Starlight1856/Seismic-Sensor-From-Hard-Drive-/misc/IMG_20210722_235536.jpg

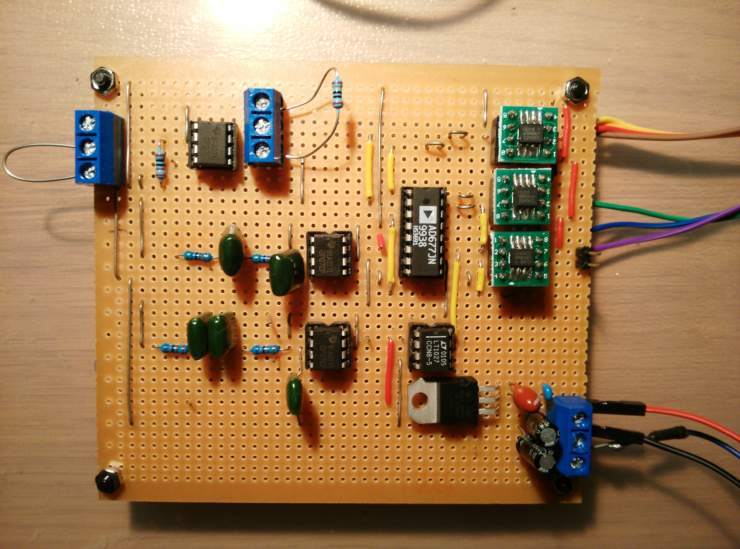
misc/IMG_20210722_235536.jpg
