Starlight1856/Seismic-Sensor-From-Hard-Drive-/misc/seismic3d_bb.jpg

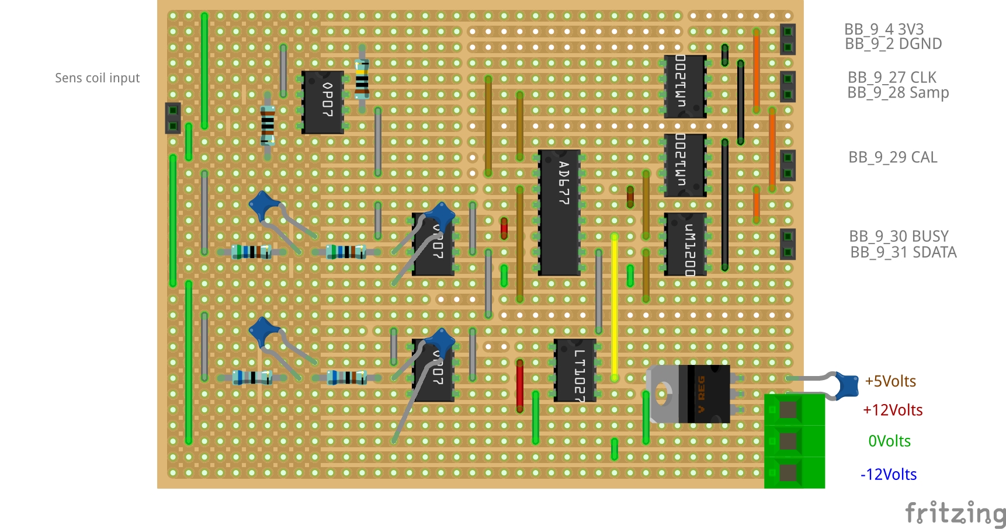
misc/seismic3d_bb.jpg
