Starlight1856/Seismic-Sensor-From-Hard-Drive-/lpfilter/butterworthtable.pdf

BASIC LINEAR DESIGN

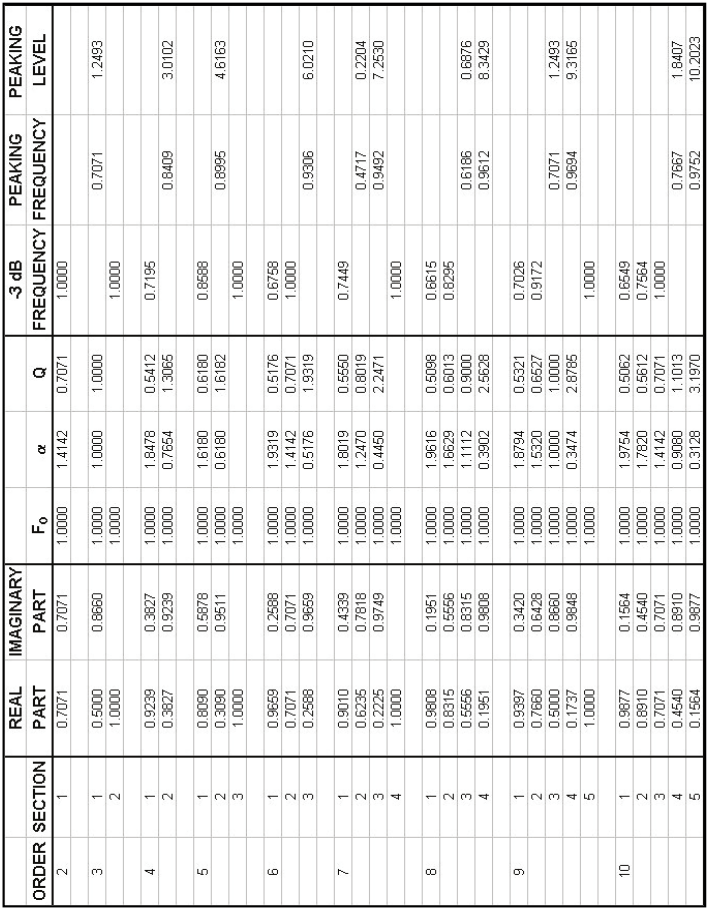
[picture p3: figure]

8.42

Figure 8.26: Butterworth Design Table
