Starlight1856/Seismic-Sensor-From-Hard-Drive-/lpfilter/rough working.pdf

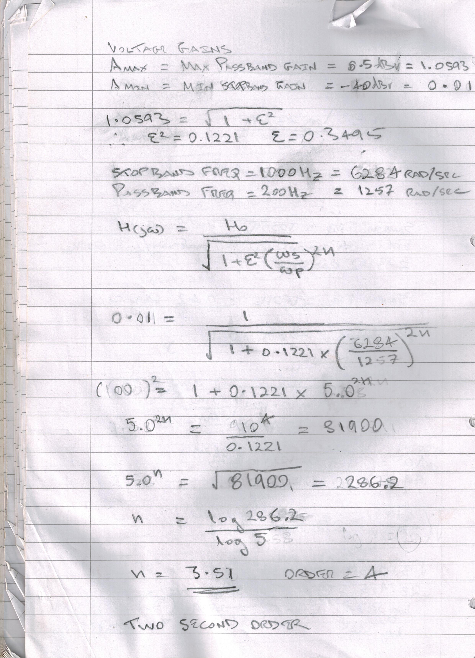
[picture p4: page 1]
