Starlight1856/Seismic-Sensor-From-Hard-Drive-/lpfilter/filter10k_npf.jpg

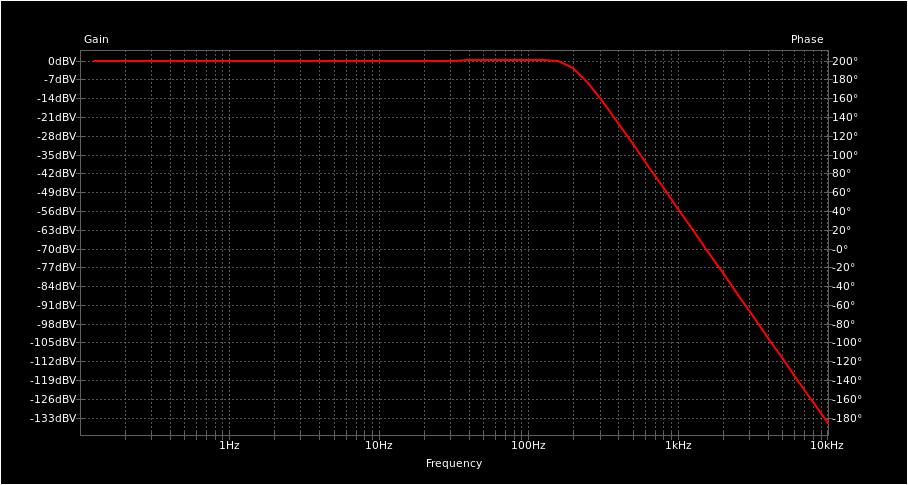
lpfilter/filter10k_npf.jpg
