Starlight1856/Seismic-Sensor-From-Hard-Drive-/misc/bitscope_prubitbang.png

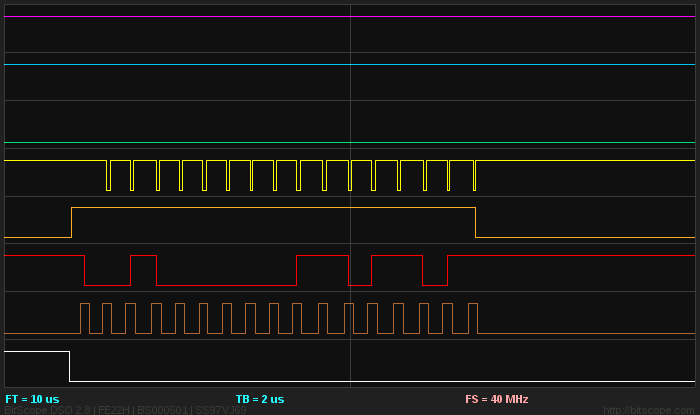
misc/bitscope_prubitbang.png
