Starlight1856/Seismic-Sensor-From-Hard-Drive-/misc/Figure_3.png

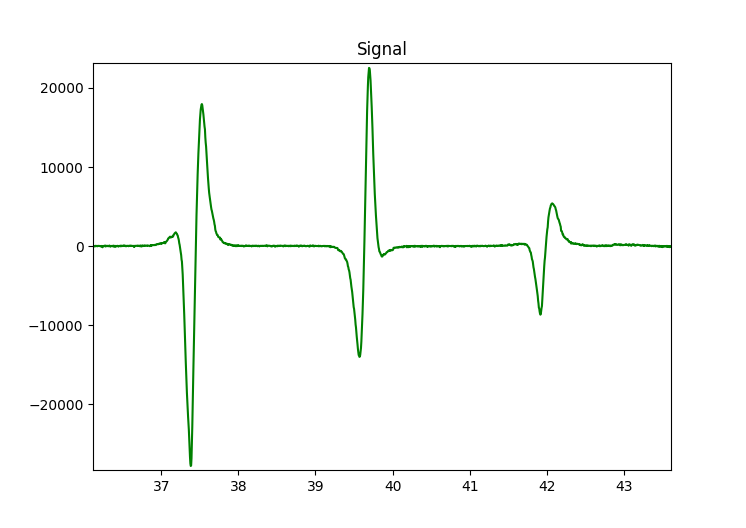
misc/Figure_3.png
