Starlight1856/Seismic-Sensor-From-Hard-Drive-/misc/seismic_circuit.pdf

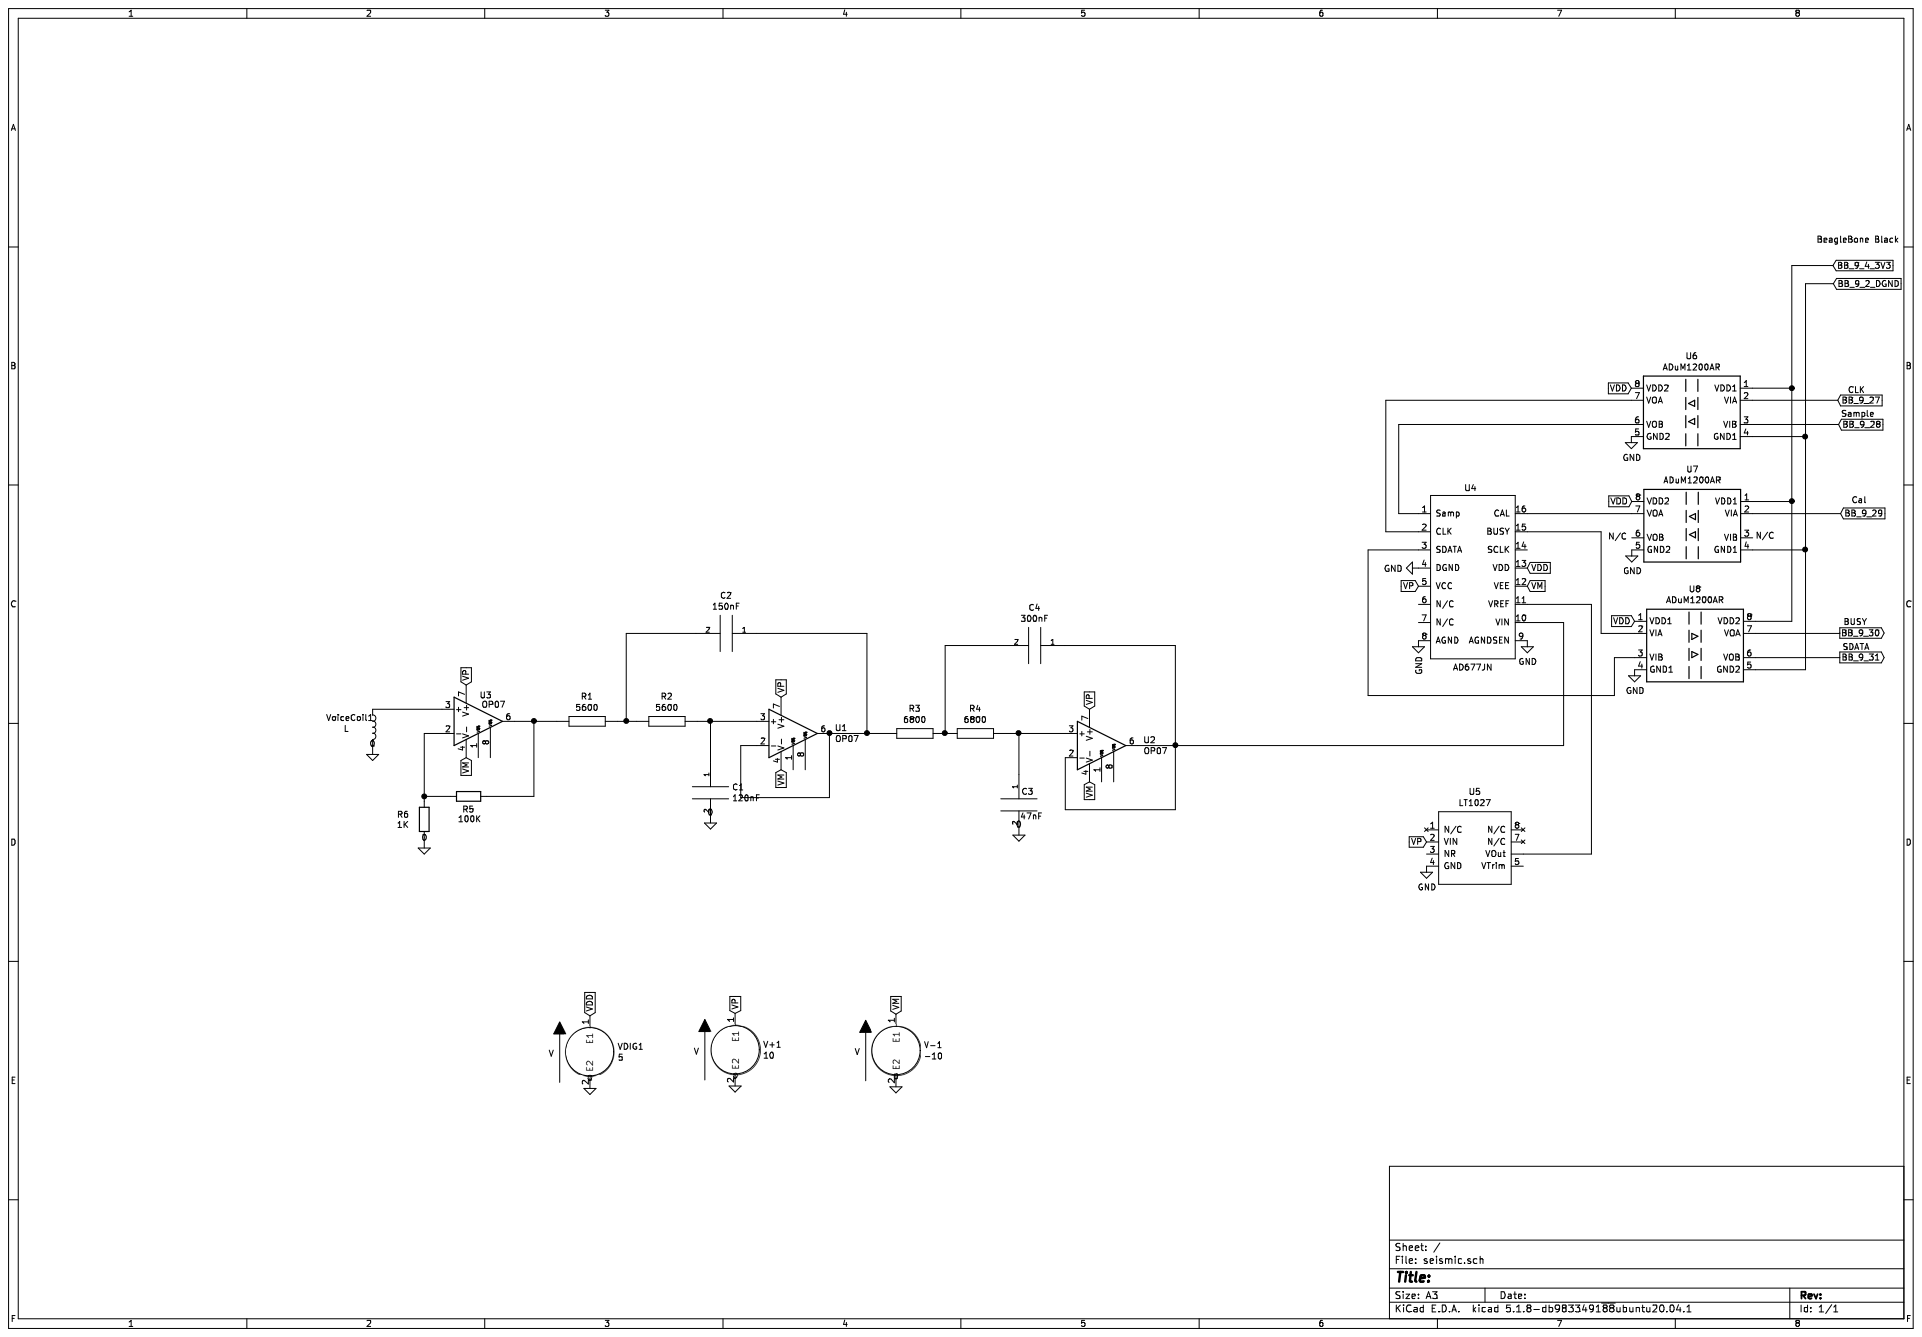
[picture p8: page 1]
